NessieCircuits/Riotee_Board/(threads)

Thread 1 (2023-02-02):

Riotee Big - a second generation module capable of running Linux (32-64MB RAM) and with at least 2 microphone inputs

dumblob, 2023-02-02:
I noticed the campaign on Crowdsupply and it looks great. Congratulations!

For my use cases I would need to run Linux on the Cortex (or maybe a slightly faster Cortex, but not necessarily) and would need to have the possibility to connect 2 separate mono microphones.

Do you have such plans for the future?

My use case would be to make a custom board and/or shield with a battery pack, SD card (for Linux + storage), 2 mic pinouts (mics themself would not be on board) and an LTE chip. All that in a smallest possible package :wink:.

geissdoerfer, 2023-02-02:
Hi, thanks! Your project sounds interesting. However our focus is on battery-free devices. Running Linux requires a more capable SoC and would be a great challenge without a continuous power supply. I'm not aware of any research in that direction.

For your particular project I would probably look into something like a Raspberry Pi or Beaglebone. They run Linux out of the box and you can power them from batteries.

dumblob, 2023-02-02:
Thanks for the quick reply!

Yeah, all other platforms I know about are really huge. I envision/need it of less than 70% of the size of a raspi pico (not counting the battery).

Closed 2023-02-02.

Thread 2 (2025-03-12):

Current consumption in RTC Power-Off Mode

a31718318, 2025-03-12:
Hi,

I am currently using a Riotee Board in combination with a SparkFun SHTC3 Board (with the LED disabled), powered through the 2V pin. I've noticed some unusual current consumption in RTC power-off mode, as depicted in the figure below, with several current spikes around 25 mA. Is this behavior normal? I am supplying power to the module via VIN with 2V from the Nordic Power Profiler Kit II, and I am measuring the current flowing to the module.

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

Code used:

```c
#include "nrf.h"
#include "riotee_am1805.h"
#include "riotee.h"
#include "riotee_gpio.h"
#include "riotee_timing.h"
#include "riotee_ble.h"
#include "riotee_thresholds.h"
#include "riotee_uart.h"
#include "shtc3.h"
#include "printf.h"
#include <limits.h>
#include "riotee_gpio.h"

const uint8_t adv_address[] = {0x01, 0xEE, 0xC0, 0xFF, 0x03, 0x02};
const char adv_name[] = "RIOTEE";

static shtc3_res_t th_result;

void earlyinit(void)
{
  shtc3_init();
}

void lateinit(void) {
  int rc;
  if ((rc = riotee_am1805_init()) != 0)
    printf("Error initializing RTC: %d\r\n", rc);
 riotee_ble_init();
}

void bootstrap(void) {
  /* Reset RTC once after programming. */
  riotee_am1805_reset();
}

void am1805_poweroff(unsigned int seconds) {

  int rc;
  struct tm date_off;

  /* Read current date from the RTC. */
  riotee_am1805_get_datetime(&date_off);
  /* Add seconds. */
  date_off.tm_sec += seconds;
  /* Ensure that this is a correct date. */
  mktime(&date_off);
  //printf("Setting alarm at %02d:%02d:%02d\r\n", date_off.tm_hour, date_off.tm_min, date_off.tm_sec);

  /* Clear interrupt from previous alarm. */
  riotee_am1805_clear_alarm();

  /* Set an alarm that will re-enable the power supply. */
  riotee_am1805_set_alarm(&date_off);
  //printf("Power off\r\n");

  /* Disable the power supply with the p-MOSFET. */
  if ((rc = riotee_am1805_disable_power()) != 0)
    printf("Error disabling power: %d\r\n", rc);

}

int main(void) {

riotee_ble_init();
  riotee_ble_adv_cfg_t adv_cfg = {.addr = adv_address,
                                  .name = adv_name,
                                  .name_len = 6,
                                  .data = &th_result,
                                  .data_len = sizeof(shtc3_res_t),
                                  .manufacturer_id = RIOTEE_BLE_ADV_MNF_NORDIC};
  riotee_ble_adv_cfg(&adv_cfg);

  for (;;) {
    riotee_wait_cap_charged();
    shtc3_read(&th_result);
    riotee_ble_advertise(ADV_CH_ALL);
	  am1805_poweroff(1800);
    riotee_sleep_ms(1000);
  }
}
```

geissdoerfer, 2025-03-12:
See https://www.riotee.nessie-circuits.de/docs/latest/current_consumption.html#measuring-current-consumption for how to measure the current consumption of the Riotee Board.

geissdoerfer, 2025-03-12:
Wait, I may have read your description wrong. You are providing 2V on the `VIN` pin and the SHTC3 is connected to the `+2V` pin, correct? And you're measuring the current flowing into the `VIN` pin?

a31718318, 2025-03-13:
Hi,

This is the setup that I am currently using.

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

geissdoerfer, 2025-03-13:
Thank you for the clarification. What are you trying to measure with this setup?

a31718318, 2025-03-13:
The overall power consumption of the device. I have a board with a harvester, and I am powering the Riotee using the output regulator. However, Riotee has an integrated harvester, which might be the issue. Is there a way to bypass it? Perhaps this will resolve the issue of the unusual current consumption.

geissdoerfer, 2025-03-13:
That sounds like a rather unusual usecase for Riotee. Can you tell me more about your harvester? Which parts of Riotee do you want to still use (Capacitor, Voltage Monitoring, Buck Converter)?

On the Riotee Module, you could connect your harvester to `Vcap` and enable the buck converter via the `EnableBuck`pad from external circuitry. But this pad isn't accessible on the Riotee Board.

a31718318, 2025-03-13:
Currently using AEM10941 Solar Harvester and i am trying to power Riotee via the HV regulator (1.8V Configuration).

My idea is to use the Riotee, but I might bypass the integrated harvester and buck converter. What if I power directly on the +2V(Aon) pin? Will this still allow for voltage monitoring?

Closed 2025-03-14.
