NessieCircuits/Riotee_Board/(commit log)

2023-01-19 add kibot 3dmodel build
    [riotee-board.kicad_pcb]
2023-01-22 add fourth level converter for simultaneous programming + TX/RX
    [controller.kicad_sch, level_shifter.kicad_sch, module.kicad_sch, riotee-board.kicad_pcb, riotee-board.kicad_sch, usb_power.kicad_sch]
2023-01-23 fix some net names
    [controller.kicad_sch, level_shifter.kicad_sch, riotee-board.kicad_sch]
2023-01-31 update kicad library
2023-01-31 add assembly plan to CI/CD build
    [riotee-board.kicad_pcb]
2023-02-02 adjust values of level translator series resistors
    [level_shifter.kicad_sch, riotee-board.kicad_sch]
2023-02-20 replace target supply diode with analog switch
    [controller.kicad_sch, level_shifter.kicad_sch, module.kicad_sch, riotee-board.kicad_pcb, riotee-board.kicad_sch, usb_power.kicad_sch]
2023-04-05 change to 4 layer board
    [riotee-board.kicad_pcb]
2023-04-12 rename pins and add component description
    [controller.kicad_sch, level_shifter.kicad_sch, module.kicad_sch, riotee-board.kicad_sch, usb_power.kicad_sch]
2023-04-12 update silkscreen
    [riotee-board.kicad_pcb]
2023-04-15 fix position of pin header and module
    [riotee-board.kicad_pcb]
2023-04-15 refine BOM
    [controller.kicad_sch, level_shifter.kicad_sch, module.kicad_sch, riotee-board.kicad_pcb, usb_power.kicad_sch]
2023-04-21 add conformity marks
    [riotee-board.kicad_pcb]
2023-05-06 migrate project to kicad 7
    [controller.kicad_sch, level_shifter.kicad_sch, module.kicad_sch, riotee-board.kicad_pcb, riotee-board.kicad_sch, usb_power.kicad_sch]
2024-06-26 update to kicad 8
    [controller.kicad_sch, level_shifter.kicad_sch, module.kicad_sch, riotee-board.kicad_pcb, riotee-board.kicad_sch, usb_power.kicad_sch]
2024-10-15 generate bom and gerber in github workflow with kibot
